ROHANSHINDE1234/Invertor/EE20_Transformer_Spec_RevE_FINAL.docx

STAGE 1 PUSH-PULL TRANSFORMER

Final Bench-Test Spec — Measured Window + Available SWG Wire

EE2005S core, AL=227nH/T² — best design point achieved across all revisions

REV E CHANGE: Uses directly MEASURED bobbin window (12.5mm axial x 3mm radial = 37.5mm², larger than the 34mm² estimate used in Rev D) and the ACTUAL wire on hand (SWG30/32/34/36/38 — NOT SWG25/38 as earlier revisions assumed). This is the best-performing design across all revisions: magnetizing current ratio improved to 178% (from 337-599% in prior revisions).

# 1. Overview

Core | EE2005S, CF139 grade, GAPPED, AL = 227 nH/turn²
Bobbin window (measured) | 12.5mm axial x 3mm radial build = 37.5mm²
Switching frequency | 25 kHz (Tsw=40µs)
Gate timing | Q1 ON 16µs (40%) → dead 4µs (10%) → Q2 ON 16µs (40%) → dead 4µs (10%)
Input voltage | Fixed 12V DC (bench supply)
Target output power | 10W
Target DC bus voltage | 325V DC
Bus capacitor rating | 400–450V recommended for this bench setup

# 2. Turns Ratio

ton per MOSFET | 16µs (effective D=0.80 of half-period)
Turns ratio (n) | 17.00
Output check | ≈326.4V — matches target

# 3. Winding Schedule

Winding | Pins | Turns | Wire | Strands | Layers | DCR
Primary half A | 1→2 | 22 | SWG32 magnet wire | 3 (bifilar) | 2 | ≈0.69mΩ
Primary half B | 2→3 | 22 | SWG32 magnet wire | 3 (bifilar) | 2 | ≈0.69mΩ
Secondary | 7→12 | 374 | SWG38 magnet wire | 1 | 6 | ≈0.17Ω

- Pin 2 = primary center tap.
- Both primary halves wound in the SAME rotational direction (absolute direction doesn't matter, consistency does).
- Primary: 22 turns/half, 3-strand bifilar SWG32, 2 layers (≈13 turns/layer).
- Secondary: 374 turns, single-strand SWG38, 6 layers (≈72 turns/layer).

# 4. Inductance Values (QC bench check)

Primary, one half | 109.9 µH ±10% (= 227nH × 22²)
Primary, total (center tap floating) | 439.5 µH ±10% (= 227nH × 44²)
Secondary | 31.75 mH ±10% (= 227nH × 374²)

# 5. Magnetizing Current — Improved, Still a Known Limitation

178% mag/load ratio is the BEST result across every revision (vs 337-599% previously) — a direct benefit of the larger real window allowing more primary turns. Still above the <20% ideal, so expect a warm core, but this is the most favorable operating point achieved.

Magnetizing inductance (Lm) | 109.9 µH
Magnetizing current, peak | ≈1.75A
Estimated load current | ≈0.98A
Magnetizing / load ratio | ≈178%

# 6. Wire Gauge & Current Density

Primary RMS current | ≈1.41A
Primary wire | 3x SWG32 bifilar per half (thinnest available combo that fits at this turns count)
Primary current density | ≈7.95 A/mm² — above 4A/mm² ideal, but improved vs. prior revisions
Secondary RMS current | ≈31mA
Secondary wire | 1x SWG38
Secondary current density | ⑈1.70 A/mm² — comfortable margin

# 7. Window Fill Verification

Bobbin winding cross-section (Aw, measured) | 37.5 mm² (12.5mm axial × 3mm radial)
Usable window budget (Ku=0.4) | 15.0 mm²
Primary copper area used | 7.78 mm²
Secondary copper area used | 6.79 mm²
Total copper area used | 14.57 mm² — 97.1% of budget, 2.9% spare margin

Margin is tight — wind carefully, avoid loose/overlapping turns.

# 8. Winding Sequence

1. Preparation: apply 1 layer of 0.05mm polyester tape to the bare bobbin.
2. Primary half A: start lead to Pin 1. Wind 22 turns of 3-strand bifilar SWG32, 2 layers (≈13 turns/layer). Finish lead to Pin 2.
3. Insulation: 1 layer polyester tape.
4. Primary half B: start lead to Pin 2 (center tap). Wind 22 turns, SAME rotational direction as half A, 2 layers. Finish lead to Pin 3.
5. Insulation: 2 layers polyester tape — primary/secondary safety barrier.
6. Secondary: start lead to Pin 7. Wind 374 turns of single-strand SWG38 across 6 layers (≈72 turns/layer), with 1 layer of thin tape between each secondary layer. SWG38 is fragile — wind carefully. Finish lead to Pin 12.
7. Final wrap: 2 layers polyester tape over the completed winding.
8. Core assembly: assemble the gapped E-halves as supplied. Secure with high-temp tape or clamp.
9. Lead dress: secure all leads at the bobbin exit point.

# 9. Bill of Materials

Component | Spec | Qty per unit
Core | EE2005S, CF139, AL=227nH/T² | 1 set
Bobbin | EE20-type, 5+5 pin | 1
Primary wire | SWG32 magnet wire | ≈4.22m (both halves, 3 strands)
Secondary wire | SWG38 magnet wire | ≈17.4m
Layer insulation tape | 0.05mm polyester film tape | ≈0.3m total
Bus capacitor | 400–450V rated | 1

# 10. QC Checks

Inductance | Primary half: 109.9µH ±10%. Secondary: 31.75mH ±10%
DCR | Primary half ≈0.69mΩ. Secondary ≈0.17Ω ±15%
Bench voltage | 12V input, confirmed timing: output should settle near 325V ±10%
Thermal | Expect a warm core (Section 5) — monitor during testing

# Appendix: Calculation Trail

Window: measured 12.5mm axial x 3mm radial build = 37.5mm² total cross-section. Usable budget at Ku=0.4 fill factor = 15.0mm².

Turns ratio: n=(325+1.5)/(2×12×0.80)=17.00 (unchanged from Rev D — wire/window changes don't affect this formula).

Primary turns: swept Nph from 6-40 against window fit with available wire combinations (SWG30/32/34 x2/3/4 strands). Nph=22 with 3x SWG32 is the largest turns count that both fits the window AND uses the best available current-carrying combination.

Secondary turns: Nsec=round(17.00×22)=374.

Magnetizing inductance: Lm=227nH×22²=109.9µH. Magnetizing current: Imag=(12×16µs)/109.9µH=1.75A.

Load current: Iload=10/(12×0.85)=0.98A. Ratio=1.75/0.98=178%.

Primary Irms=sqrt(0.98²+(1.75/√3)²)=1.41A. J(3xSWG32, area=0.0590mm²/strand)=1.41/(3×0.0590)=7.95A/mm².

Secondary Irms≈10/325=30.8mA. J(SWG38, area=0.0181mm²)=30.8mA/0.0181mm²=1.70A/mm².

Window fill: primary copper=22×2halves×3strands×0.0590mm²=7.78mm². Secondary copper=374×0.0181mm²=6.79mm². Total=14.57mm² vs 15.0mm² budget (2.9% margin).

SWG diameters used (bare copper, per standard SWG table): SWG30=0.315mm, SWG32=0.274mm, SWG34=0.234mm, SWG36=0.193mm, SWG38=0.152mm.

REVISION HISTORY: Rev D used an estimated 34mm² window and assumed SWG25/38 wire. Rev E (this document) uses the customer's directly measured 37.5mm² window and the customer's actual available wire stock (SWG30/32/34/36/38), superseding all turns counts and current density figures in Rev D.

Stage 1 Push-Pull Transformer — 12V/10W — Rev E (FINAL)
