ROHANSHINDE1234/Invertor/Transformer_Design_Revision_History.docx

TRANSFORMER DESIGN

Complete Revision History

Stage 1 Push-Pull DC-DC Converter, 12V → 325V

PURPOSE OF THIS DOCUMENT: This is a chronological record of every major design change made, WHY each change happened, and what triggered it. Read this alongside the final build spec (Rev E) to understand how the design arrived at its current numbers, and which assumptions still need bench verification.

# Revision Timeline at a Glance

Rev | Core/Window basis | Key numbers (Nph/Nsec/n) | Trigger for change
A | EE35, ungapped, estimated window | n=72→19; 4→16 turns/half | Initial n=72 found unjustifiable; re-derived from duty-cycle margin
B | Switched to EE20/EE2005S core (team had this in stock) | Nph=14, Nsec=565, n=40.4 | AL=227nH (gapped) made EE35 turns ratio invalid for this core
C | Same core, fixed 12V input (not 10–15V range) | Nph=16, Nsec=363, n=22.67 | User rejected 710V worst-case theoretical ceiling; bench-only scope set
D | Same core, CORRECTED gate timing | Nph=16→12→22 (see below), n=17.00 | User corrected duty-cycle definition (40%/10%/40%/10% of FULL period)
E (final) | MEASURED window (12.5×3mm), ACTUAL stock wire (SWG30–38) | Nph=22, Nsec=374, n=17.00 | Real caliper measurements + real wire inventory replaced estimates

# Revision A → B: Core Change (EE35 → EE20)

Original design used an EE35 core with assumed/typical Ae, le, µr values (never from a confirmed datasheet). The electrical team’s actual available core was an EE20-class (EE2005S, Cosmo Ferrites), with a real datasheet confirming AL=227nH/turn² — a GAPPED core.

This was a significant trigger: the EE35 turns ratio (n=19) did not transfer to EE20, because:

- EE20's much smaller winding window (vs EE35) couldn't fit the EE35-derived turns counts.
- AL=227nH is a low, gapped-core value — gapped cores are normally chosen for LOW magnetizing inductance (e.g. flyback), which is the opposite of what a push-pull primary wants.
- Sweeping primary turns showed window-fit and acceptable-magnetizing-current requirements didn't overlap at ANY turns count on this core — a structural mismatch, not a tuning problem.

Decision: proceed with the available EE20/AL227 core anyway (team had it in hand, didn't want to wait on procurement), accepting elevated magnetizing current as a documented, known limitation rather than an error.

# Revision B → C: Fixed 12V Input (Removed Battery Range)

This was the most safety-critical correction in the whole process.

Rev B was sized for a 10–15V battery range (worst-case 10V). At that corner, duty cycle could rise toward ~88%, and the chosen turns ratio meant output could theoretically reach ~710V if the control loop ever lost regulation — far beyond safe bus capacitor ratings for a battery-powered build.

User explicitly rejected this: “I cannot accept a 710V design.” Scope was redefined: fixed 12V bench supply (not battery), 10W (down from 12W), explicitly a tabletop proof-of-concept. Battery sag, protection circuitry, and field robustness deferred to a later phase.

Result: turns ratio re-derived around a single fixed operating point (initially D=0.6, picked without re-deriving from the actual gate-timing constraint — this became the trigger for Rev D).

# Revision C → D: Corrected Gate Timing Definition

This revealed a real modeling mistake on Claude's part, not just a clarification.

Rev C used D=0.6 as duty cycle, picked as “a sensible centered value” without checking it against the user's already-established dead-time/cross-conduction requirement. When asked to justify it, the honest answer was: it wasn't derived from anything, it was a convenient round number.

Three rounds of clarification followed on what “duty cycle” meant:

- Attempt 1: D=0.40 of each MOSFET's own half-period (ton=8µs) — user clarified this was not what they meant.
- Attempt 2: User's restated definition — 40% ON / 10% dead / 40% ON / 10% dead, ALL relative to the FULL switching period (ton=16µs). This is double Attempt 1's on-time.
- This was confirmed as final: ton=16µs, dead time=4µs per gap (8x margin over the 500ns minimum established earlier).

Re-deriving turns ratio with the correct ton=16µs gave n=17.00 (lower than Rev C's 22.67, since longer conduction time delivers more volt-seconds, needing fewer secondary turns for the same 325V target). Window-fit sweep under this corrected timing capped primary turns at Nph=16 (using AWG25/38 assumptions still in place at this point).

# Revision D → E: Real Measurements Replace Estimates

Two remaining assumptions were replaced with real data from the user's electrical team:

## 1. Wire gauge: AWG → SWG (and then to ACTUAL stock)

All prior revisions assumed AWG25/AWG38 wire. The team's actual stock was SWG, not AWG — confirmed to be a real difference, not a units relabeling: SWG25 is 1.25x the cross-sectional area of AWG25; SWG38 is 2.26x the area of AWG38. Re-running the window fit with true SWG25/38 dimensions broke the Rev D fit (window overflow), forcing Nph down to 12 and pushing magnetizing current ratio up to 599% — the worst point in the whole process.

Further checking with the electrical team revealed SWG25/38 were not even the correct available stock — actual inventory was SWG30/32/34/36/38 (all thinner than initially stated).

## 2. Bobbin window: estimated → measured

Earlier revisions relied on researched typical EE20/EF20 bobbin window figures (~34mm²), since no manufacturer datasheet for the exact bobbin was available, and an attempt to read dimensions from photos was explicitly flagged as too imprecise (±0.5–1mm uncertainty on an already-small window).

The user's team measured the actual bobbin directly with a vernier caliper: 12.5mm axial winding length × 3mm radial build = 37.5mm² — close to, but meaningfully larger than, the earlier estimate.

Combining the real window (larger than estimated) with the real wire stock (SWG30–38, available in multiple gauges) allowed a sweep across wire/strand combinations, landing on the best result of the entire process: Nph=22 (3x SWG32 bifilar), Nsec=374 (SWG38), magnetizing current ratio improved to 178% (down from a peak of 599% in the SWG25/38 attempt, and better than every AWG-based attempt too).

# Other Corrections Made Along the Way

Topic | What was initially said/assumed | What was corrected to
Rectifier topology | Center-tapped secondary + 2 diodes (initial default) | User proposed single winding + bridge rectifier — confirmed as a legitimate, arguably better alternative given this design's voltage stress profile
Winding direction | N/A (not yet discussed) | Absolute direction (CW/CCW) is irrelevant; the two primary halves must be wound in the SAME relative direction, or flux will fight rather than alternate cleanly
Magnetizing current vs. thermal risk | Initial framing as primarily a heating/efficiency concern | Corrected: I²R copper loss from magnetizing current is small in absolute watts (mW range); the real risk is core flux/saturation margin and MOSFET current stress, not simple resistive heating. A naive loss estimate (1.7% of Pout) was flagged as misleadingly reassuring and not trusted
AL=227nH source check | Assumed it might be a labeling error | Confirmed genuine: this IS a deliberately gapped core variant (CF139 EE2005S, gapped), distinct from the same core's ungapped OL variant (AL≈1450nH)

# What Has NOT Been Independently Verified

These remain planning assumptions, not bench-measured facts. The design is buildable and ready for first power-up, but should not be called “final” in the sense of having no remaining unknowns.

- Winding utilization factor Ku=0.4 — a standard planning value, not measured from an actual wound sample. Current design margin (2.9%) is thin enough that a real Ku of 0.35 could cause a physical fit problem.
- Stage 1 efficiency η=0.85 — an assumed planning figure, not measured.
- MLT (mean length per turn) and resulting DCR — from a simplified geometric model of the former + winding buildup, not a measured wound coil.
- Insulated wire diameter (enamel buildup) — typical values used for layer/turns-per-layer planning, not the actual measured insulated diameter of the specific spools on hand.
- Core loss / real operating temperature — no reliable estimate exists; an attempted Steinmetz-scaling extrapolation was explicitly flagged as unreliable given how far the operating point is from the datasheet's reference measurement condition.

# Current Status

Rev E is the design to build and bench-test. It is the best-performing version across the entire process (lowest magnetizing current ratio, real measured window, real available wire), but first power-up should be treated as the verification step for the assumptions listed above — not a formality.

Stage 1 Transformer — Design Revision History
