ROHANSHINDE1234/Invertor/Pushpull_ckt.asc

C1: cap; 4.7µ; V=450V
D1: diode
D2: diode
E1: e; 1
E2: e; 1
L1: ind; 333µ; Rser=1m
L2: ind; 333µ; Rser=1m
L3: ind; 1.726; Rser=1m
L4: ind; 1.726; Rser=1m
L5: ind; 1.5m; Rser=1m
M1: nmos; IRF3205
M2: nmos; IRF3205
R1: res; 7000
V1: voltage; 12.8
V2: voltage; PULSE(0 12 0 10n 10n 14.1 40u)
V3: voltage; PULSE(0 12 20u 10n 10n 14.1u 40u)
Named nets: 0
K1 L1 L2 L3 L4 0.99
