ROHANSHINDE1234/Invertor/include/hw_config.h

/*
 * hw_config.h — Hardware Configuration
 *
 * THE SINGLE SOURCE OF TRUTH for all hardware-specific definitions in this project.
 *
 * HOD RULE: No peripheral address, pin number, timing constant, or hardware
 * #define may appear in any other file. If hardware changes (pin moved, timer
 * swapped, clock speed changed), edit ONLY THIS FILE.
 *
 * Sections:
 *   1. System Clock
 *   2. Onboard LED
 *   3. Push-Pull PWM — Pin Assignments
 *   4. Push-Pull PWM — Timer Constants (derived arithmetic shown inline)
 *   5. Push-Pull PWM — Duty Cycle Limits
 *   6. Potentiometer ADC Input
 *   7. H-Bridge Output Unfolder (50 Hz)
 *   8. Gate-Drive Polarity (6N137 optocoupler compensation)
 */

#ifndef HW_CONFIG_H
#define HW_CONFIG_H

/* ════════════════════════════════════════════════════════════════════
 * 1. SYSTEM CLOCK
 *    HSE = external crystal. Confirmed by reading SystemCoreClock
 *    in the debugger (returned 8,000,000). Used in all tick derivations.
 * ════════════════════════════════════════════════════════════════════ */
#define SYSCLK_HZ               8000000UL   /* 8 MHz HSE external crystal */

/* ════════════════════════════════════════════════════════════════════
 * 2. ONBOARD LED
 *    Blue Pill onboard LED is on Port C, pin 13.
 * ════════════════════════════════════════════════════════════════════ */
#define LED_PORT                GPIOC
#define LED_PIN                 13

/* ════════════════════════════════════════════════════════════════════
 * 3. PUSH-PULL PWM — PIN ASSIGNMENTS
 *
 *    TIM4 is on APB1 (not APB2 where GPIO and TIM1 live).
 *    PB6 = TIM4 CH1 → Q1: hardware PWM output, alternate-function mode
 *    PB7 = TIM4 CH2 → Q2: hardware PWM output, alternate-function mode
 *
 *    Both channels are hardware PWM (center-aligned mode) — there is
 *    no software/ISR-driven GPIO in the gate-drive path. See pwm_driver.c
 *    for why: an earlier revision drove PB7 from TIM4_IRQHandler, which
 *    raced the hardware-timed PB6 edge and could overlap under interrupt
 *    latency, worst at high duty.
 * ════════════════════════════════════════════════════════════════════ */
#define PWM_PORT                GPIOB
#define PWM_PIN_Q1              6           /* PB6: hardware PWM (TIM4 CH1)     */
#define PWM_PIN_Q2              7           /* PB7: hardware PWM (TIM4 CH2)     */

/* ════════════════════════════════════════════════════════════════════
 * 4. PUSH-PULL PWM — TIMER CONSTANTS
 *
 *    Switching frequency: 25 kHz  →  Period = 40 µs
 *    Timer prescaler (PSC): 0     →  1 tick = 1/8 MHz = 0.125 µs
 *
 *    TIM4 runs in CENTER-ALIGNED mode: CNT sweeps 0 → ARR → 0 once per
 *    switching period, so ARR is the HALF-period tick count, not the
 *    full period:
 *      ARR = 20 µs / 0.125 µs = 160   →  full period = 2×160 = 320 ticks = 40 µs
 *
 *    Waveform targets (Rev E specification), duty_ticks = desired ON-time:
 *      Q1 (PB6, PWM mode 1, HIGH while CNT<CCR1): pulse of width
 *        2×CCR1, centered on the trough (CNT=0 / period boundary).
 *      Q2 (PB7, PWM mode 2, HIGH while CNT>=CCR2): pulse of width
 *        2×(ARR-CCR2), centered on the peak (CNT=ARR) — exactly half
 *        a period away from Q1, by construction of the timer hardware.
 *      pwm_set_duty() sets CCR1 = CCR2 = duty_ticks/2 from center,
 *      i.e. CCR1 = duty_ticks/2, CCR2 = ARR - duty_ticks/2.
 *
 *    Startup safe values (immediately overwritten by ADC on first loop):
 *      CCR1_STARTUP = PWM_DUTY_MIN_TICKS / 2  (safest state, minimum duty)
 *      CCR2_STARTUP = PWM_HALF_PERIOD_TICKS - PWM_DUTY_MIN_TICKS / 2
 * ════════════════════════════════════════════════════════════════════ */
#define PWM_FREQ_HZ             25000UL
#define PWM_PSC                 0

#define PWM_HALF_PERIOD_TICKS   160         /* 20 µs — ARR value in center-aligned mode */

/* ════════════════════════════════════════════════════════════════════
 * 5. PUSH-PULL PWM — DUTY CYCLE LIMITS
 *
 *    duty_ticks controls BOTH Q1 ON-time and Q2 ON-time equally,
 *    ensuring volt-second balance across the transformer.
 *
 *    Dead-time at each gap = (PWM_HALF_PERIOD_TICKS - duty_ticks) × 0.125 µs
 *    At max duty (128 ticks): dead-time = (160-128) × 0.125 = 4 µs ✓
 *    At min duty ( 16 ticks): dead-time = (160-16)  × 0.125 = 18 µs
 *
 *    This gap is enforced by the compare hardware on every period —
 *    unlike the earlier ISR-driven scheme, it does not depend on
 *    interrupt response time, so the 4 µs figure at max duty is a
 *    hard guarantee, not a best-case estimate.
 *
 *    CONSTRAINT: duty_ticks must stay < PWM_HALF_PERIOD_TICKS (160), or
 *    the dead-time gap collapses to zero/negative and both channels'
 *    pulses can overlap — shoot-through. MAX_TICKS = 128 keeps a solid
 *    32-tick (4 µs) margin below that limit and enforces 16 µs maximum
 *    ON-time per the Rev E spec.
 * ════════════════════════════════════════════════════════════════════ */
#define PWM_DUTY_MIN_TICKS      16          /*  2 µs ON  (minimum power)        */
#define PWM_DUTY_MAX_TICKS      128         /* 16 µs ON  (Rev E maximum)        */

/* Fixed operating duty. The pot/ADC control has been removed — the push-pull
 * now runs at this single hardcoded ON-time, set once at startup. Change this
 * one line to re-tune the operating point; it is clamped to
 * [PWM_DUTY_MIN_TICKS .. PWM_DUTY_MAX_TICKS] inside pwm_set_duty() regardless. */
#define PWM_DUTY_FIXED_TICKS    PWM_DUTY_MAX_TICKS  /* 128 ticks = 16 µs ON (Rev E) */

/* ════════════════════════════════════════════════════════════════════
 * 6. POTENTIOMETER ADC INPUT
 *
 *    200-ohm pot wiper → PA0 (ADC1, Channel 0)
 *    Pot between 3.3V and GND; wiper to PA0.
 *    ADC result: 0 (pot CCW, 0V) to 4095 (pot CW, 3.3V)
 * ════════════════════════════════════════════════════════════════════ */
#define POT_PORT                GPIOA
#define POT_PIN                 0
#define POT_ADC_CHANNEL         0

/* ════════════════════════════════════════════════════════════════════
 * 7. H-BRIDGE OUTPUT UNFOLDER  (50 Hz square-wave)
 *
 *    Second power stage. The push-pull + transformer + rectifier produce a
 *    high-voltage DC rail; this full bridge unfolds that rail into 50 Hz AC
 *    by alternating its two diagonal switch pairs.
 *
 *    Bridge legs (each leg = one high-side + one low-side switch):
 *        Leg A: HA (high) / LA (low)
 *        Leg B: HB (high) / LB (low)
 *      Positive half-cycle: HA + LB conduct   (current A → load → B)
 *      Negative half-cycle: HB + LA conduct   (current B → load → A)
 *
 *    All four gates are plain GPIO driven from the TIM3 update ISR. At 50 Hz
 *    with a 1 ms dead-time this is nowhere near timing-critical — the ISR
 *    fires only a few hundred times a second and does four BSRR writes.
 *
 *    Pins PA4–PA7 are all free on the Blue Pill (PA0 is the pot). Change here
 *    if your gate-driver board wires the four gates to different pins.
 * ════════════════════════════════════════════════════════════════════ */
#define HBRIDGE_PORT            GPIOA
#define HBRIDGE_PIN_HA          4           /* Leg A high-side gate            */
#define HBRIDGE_PIN_LA          5           /* Leg A low-side  gate            */
#define HBRIDGE_PIN_HB          6           /* Leg B high-side gate            */
#define HBRIDGE_PIN_LB          7           /* Leg B low-side  gate            */

/* TIM3 timebase for the unfolder state machine.
 *   PSC = 7 → 8 MHz / 8 = 1 MHz → 1 tick = 1 µs.
 *   Each 50 Hz period (20 ms) is built from four phases:
 *       POS active (HA+LB)  : HBRIDGE_ACTIVE_TICKS =  9 ms
 *       dead-time (all off) : HBRIDGE_DEAD_TICKS   =  1 ms
 *       NEG active (HB+LA)  : HBRIDGE_ACTIVE_TICKS =  9 ms
 *       dead-time (all off) : HBRIDGE_DEAD_TICKS   =  1 ms
 *   Total = 2 × (9 + 1) ms = 20 ms = 50 Hz.
 *
 *   The all-off dead-time inserted at EVERY polarity swap is what guarantees
 *   the bridge is never shorted top-to-bottom while a leg changes state. */
#define HBRIDGE_TIM_PSC         7           /* 1 µs per tick                    */
#define HBRIDGE_ACTIVE_TICKS    9000u       /* 9 ms conduction per half-cycle   */
#define HBRIDGE_DEAD_TICKS      1000u       /* 1 ms dead-time per polarity swap */

/* ════════════════════════════════════════════════════════════════════
 * 8. GATE-DRIVE POLARITY  (6N137 optocoupler compensation)
 *
 *    All six gate lines (push-pull PB6/PB7, H-bridge PA4–PA7) pass through
 *    6N137 optocouplers, whose output is INVERTING: current in the input LED
 *    (MCU pin HIGH) pulls the opto output LOW.
 *
 *    To preserve the real, MOSFET-level meaning — "firmware asks for ON ⇒ gate
 *    ON", and critically "dead-time (nothing asked for) ⇒ EVERY gate OFF" — the
 *    firmware drives ACTIVE-LOW so the single opto inversion is undone:
 *
 *      firmware active-low ─▶ 6N137 (inverts) ─▶ opto out active-high ─▶ driver
 *
 *    Effect per stage when GATE_DRIVE_INVERTED = 1:
 *      • Push-pull: TIM4 CH1/CH2 pin polarity flipped via CC1P/CC2P. The ON
 *        pulses become MCU-LOW (→ opto HIGH); the both-off dead-time becomes
 *        MCU-both-HIGH (→ opto both LOW = both MOSFETs off). The compare timing
 *        and 4 µs dead-time WIDTH are unchanged — only the electrical level.
 *      • H-bridge: gates written with GATE_ACTIVE / GATE_IDLE below.
 *
 *    ⚠️ ASSUMES the stage after the opto (gate driver) is NON-inverting. If that
 *    driver ALSO inverts, the two cancel — set GATE_DRIVE_INVERTED to 0, or the
 *    all-off dead-time turns into all-ON = both legs shorted. ALWAYS confirm on
 *    the bench that every gate is OFF during the dead phases, at low voltage,
 *    before applying HV.
 * ════════════════════════════════════════════════════════════════════ */
#define GATE_DRIVE_INVERTED     1           /* 1 = active-low (6N137); 0 = active-high */

#if GATE_DRIVE_INVERTED
  #define GATE_ACTIVE           0u          /* MCU level that requests "gate ON"  */
  #define GATE_IDLE             1u          /* MCU level that requests "gate OFF" */
#else
  #define GATE_ACTIVE           1u
  #define GATE_IDLE             0u
#endif

#endif /* HW_CONFIG_H */
