ROHANSHINDE1234/Invertor/(commit log)

2026-06-07 Revise README for solar-powered backup project
    Updated project details for a solar-powered backup system, including system overview, target specifications, hardware architecture, PCB design plan, and phases.
2026-06-28 Oscillations shifted to external clock
    [clock_config.c, clock_config.h, main.c]
2026-07-02 MInor error in main.c solved
    [main.c]
2026-07-03 overlapping problem there need to make respective changes
    [hw_config.h, main.c, pwm_driver.c]
2026-07-22 Waveforms verified and POT removed
    [H_bridge.csv, input_side_switching.csv]
2026-07-26 Changes made in software in accordance to 6N137 optocoupler
    [H bridge updated output 2.csv, H bridge updated output.csv, UPdated output of the primary side switching mosfet.csv]
